siredmar/FilamentRecycle/Mechanic/Caliper/FilamentRight.stl

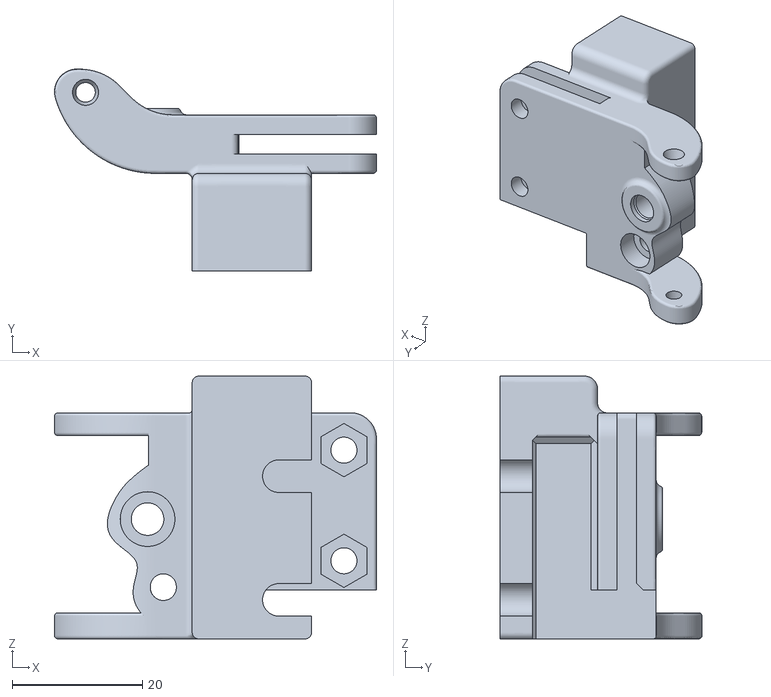
[picture p1: CAD file, 2017-01-15]
Mechanic/Caliper/FilamentRight.stl
49.5 x 31.0 x 40.4
