siredmar/FilamentRecycle/Mechanic/Caliper/FilamentLeft.stl

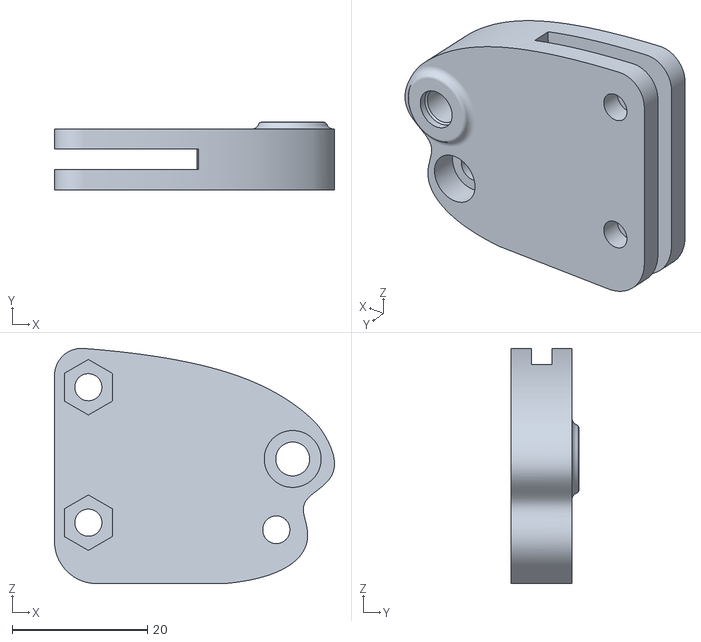
[picture p2: CAD file, 2017-01-15]
Mechanic/Caliper/FilamentLeft.stl
41.3 x 10.0 x 34.7
