siredmar/FilamentRecycle/HW/FilamentRecycle/FilamentRecyclePeriphery.brd

## EAGLE design HW/FilamentRecycle/FilamentRecyclePeriphery.brd (2017-06-21)

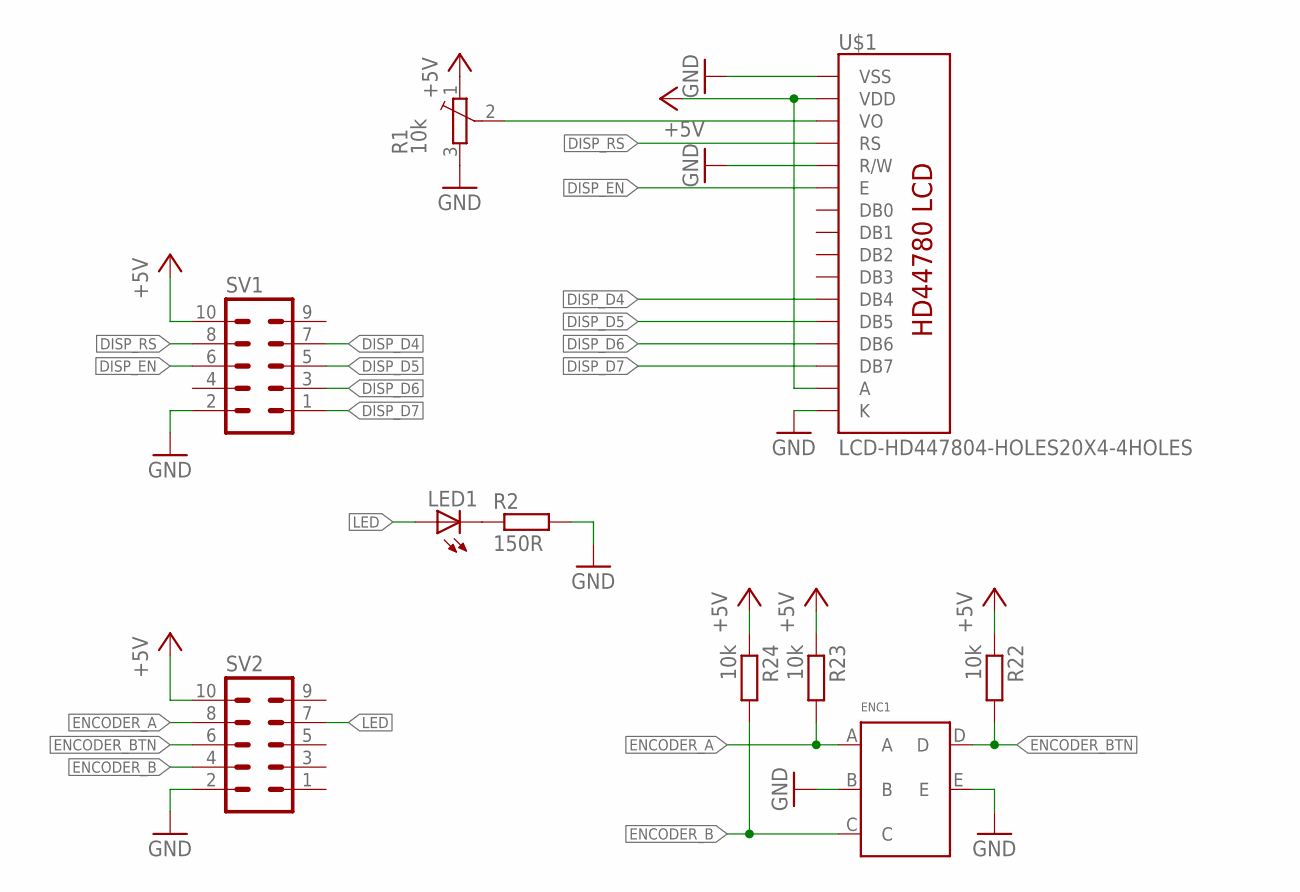
[picture p3: schematic FilamentRecyclePeriphery.sch]

Parts:
ENC1: ENCODER
LED1: LED3MM
R1: 10k; 35WR5KLFTR
R2: 150R; R0603
R22, R23, R24: 10k; R0603
SV1, SV2: ML10
U$1: LCD-HD447804-HOLES20X4-4HOLES; LCD-20X4-4HOLES

Connections:
+5V: R1.1 (E), R22.1, R23.1, R24.1, SV1.10, SV2.10, U$1.P$2 (VDD), U$1.P$15 (A)
DISP_D4: SV1.7, U$1.P$11 (DB4)
DISP_D5: SV1.5, U$1.P$12 (DB5)
DISP_D6: SV1.3, U$1.P$13 (DB6)
DISP_D7: SV1.1, U$1.P$14 (DB7)
DISP_EN: SV1.6, U$1.P$6 (E)
DISP_RS: SV1.8, U$1.P$4 (RS)
ENCODER_A: ENC1.A, R23.2, SV2.8
ENCODER_B: ENC1.C, R24.2, SV2.4
ENCODER_BTN: ENC1.D, R22.2, SV2.6
GND: ENC1.B, ENC1.E, R1.3 (A), R2.2, SV1.2, SV2.2, U$1.P$1 (VSS), U$1.P$5 (R/W), U$1.P$16 (K)
LED: LED1.A, SV2.7
unnamed: LED1.K (C), R2.1
unnamed: R1.2 (S), U$1.P$3 (VO)

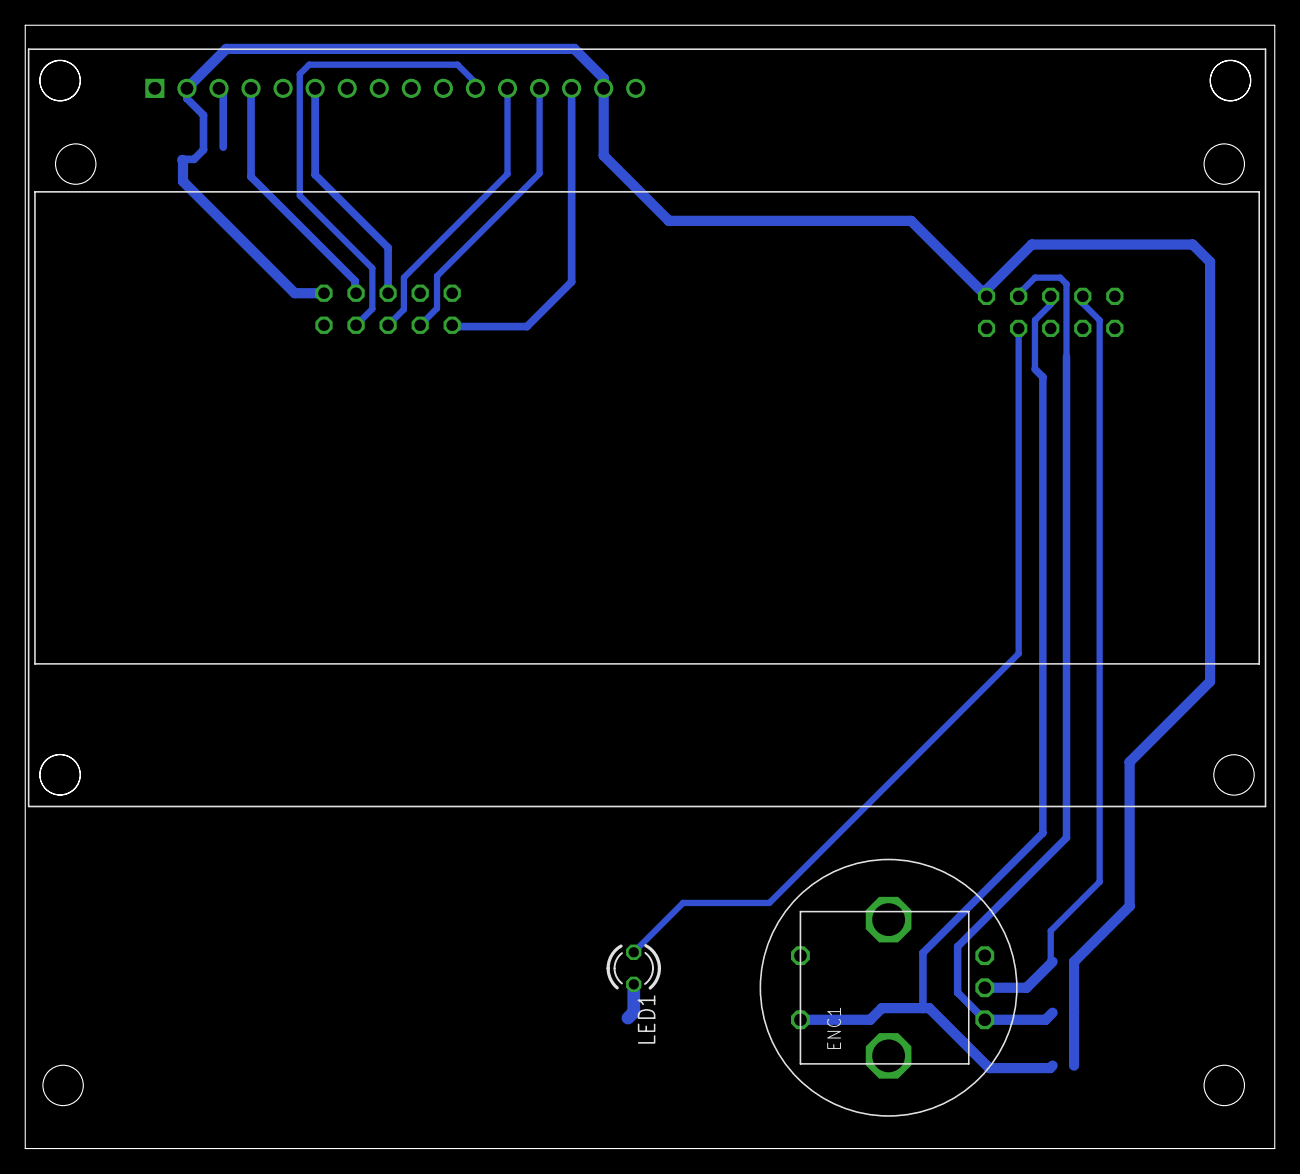
[picture p4: board FilamentRecyclePeriphery.brd from above]

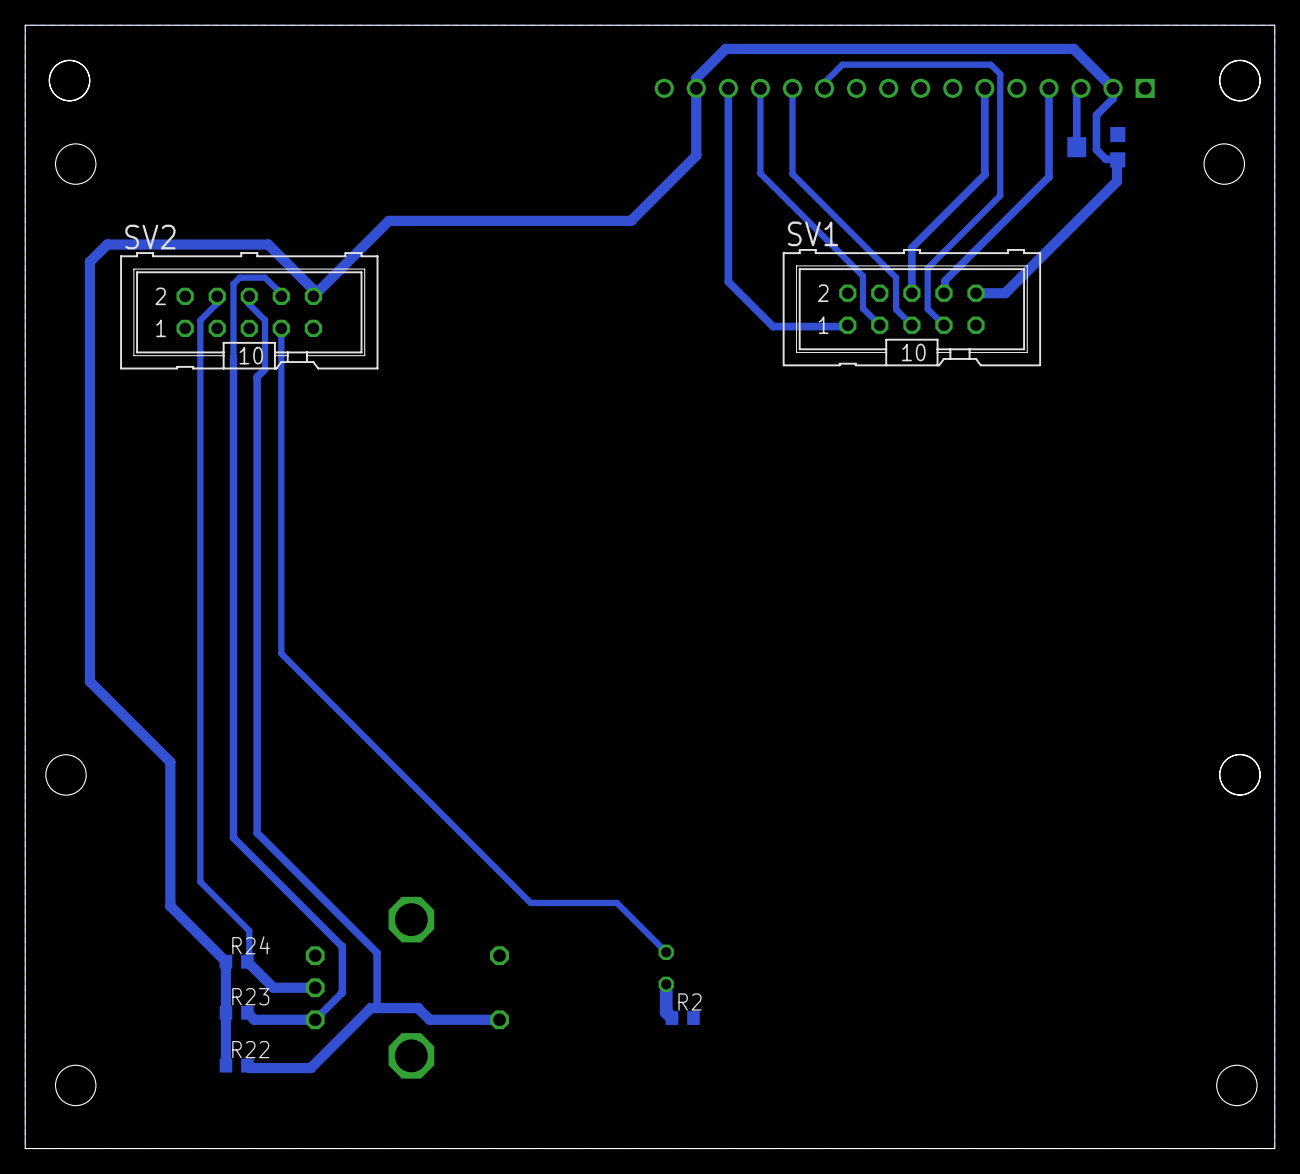
[picture p5: board FilamentRecyclePeriphery.brd from below]

Board: 2 copper layers, 99.0 x 89.0 mm, 10 parts (7 on the bottom side), 14 nets.
