siredmar/FilamentRecycle/HW/FilamentRecycle/FilamentRecycle.brd

## EAGLE design HW/FilamentRecycle/FilamentRecycle.brd (2017-06-21)

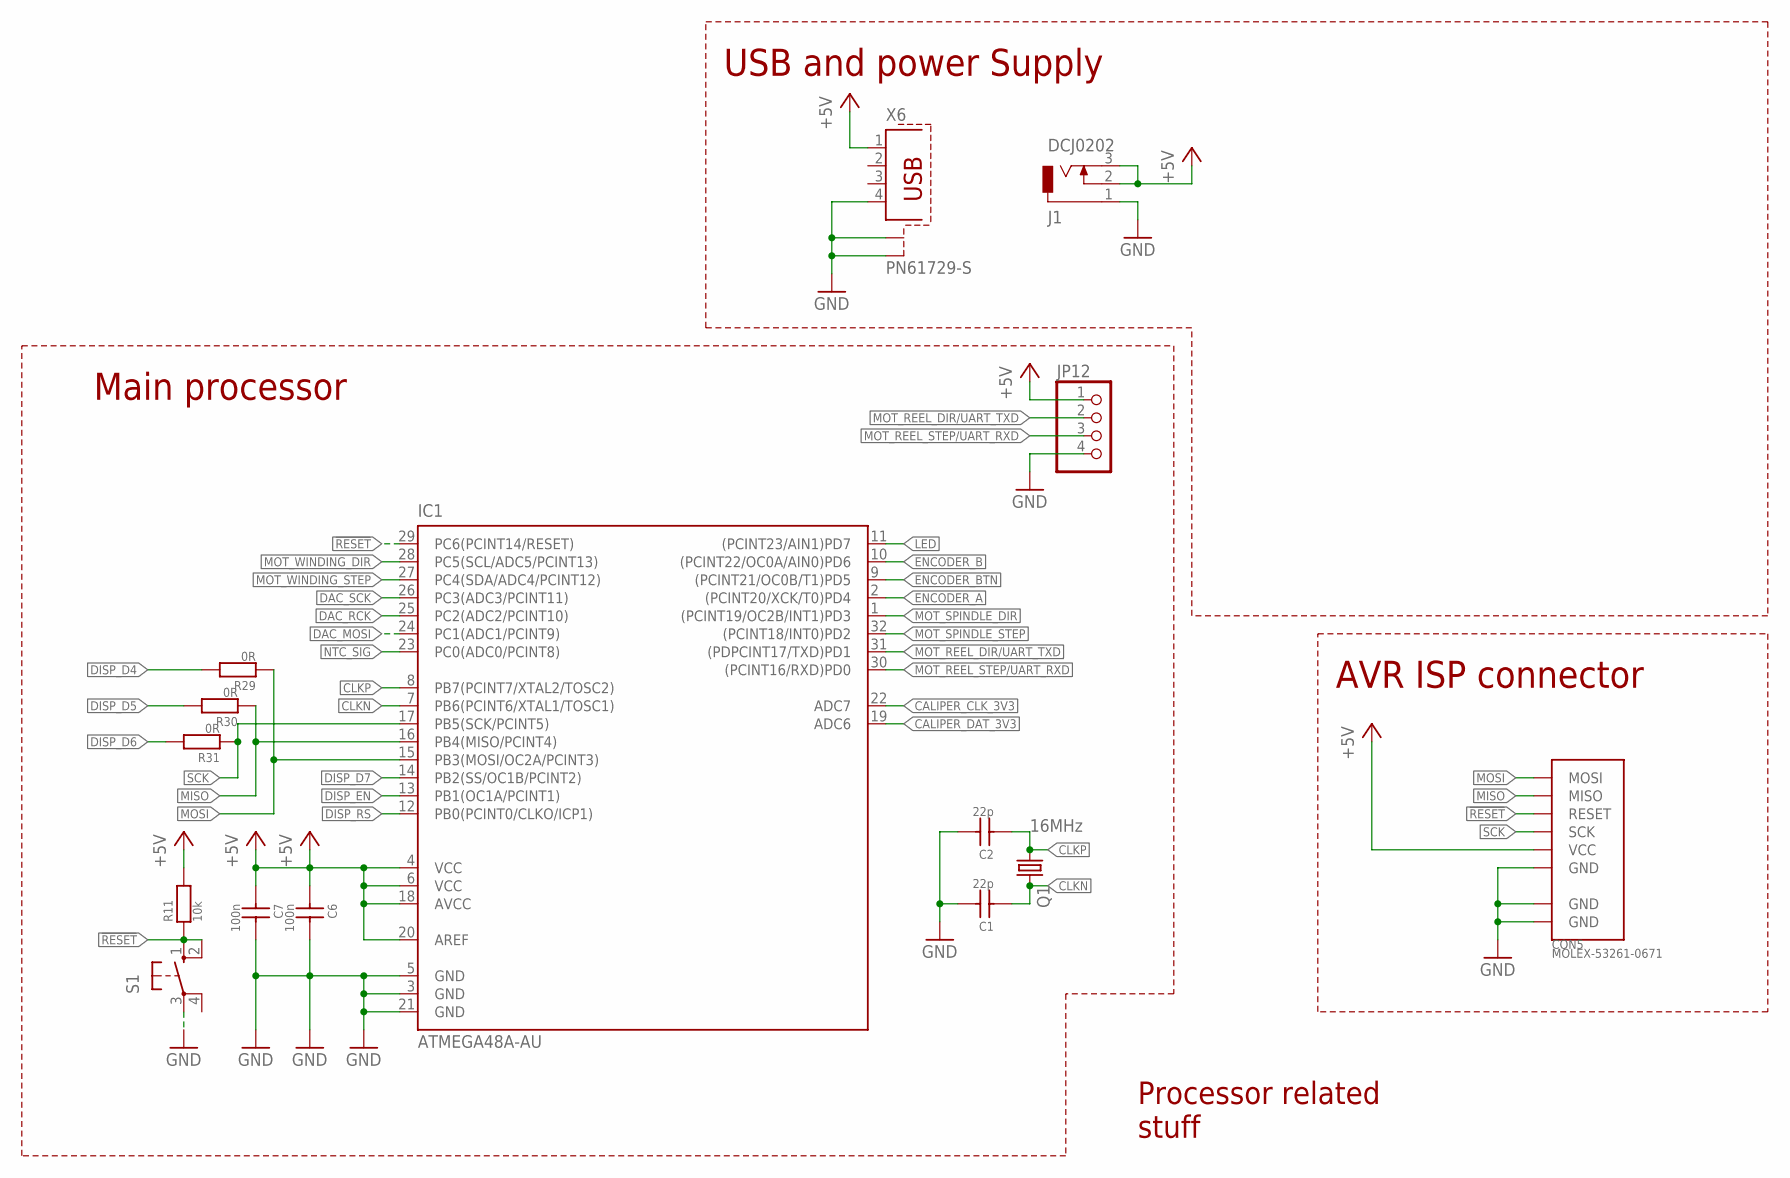
[picture p6: schematic FilamentRecycle.sch, sheet 1]

Parts:
C1, C2: 22p; C0603
C6, C7: 100n; C0603
CON5: MOLEX-53261-0671
IC1: ATMEGA48A-AU; TQFP32
J1: DCJ0202
JP12: PINHD-1X4; 1X04
Q1: 16MHz; HC49UP
R11: 10k; R0603
R29, R30, R31: 0R; R0603
S1: 10-XX; B3F-10XX
X6: PN61729-S

Connections:
!RESET: CON5.3 (RESET), IC1.29 (PC6(PCINT14/RESET)), R11.1, S1.1 (S), S1.2 (S1)
+5V: C6.1, C7.1, CON5.5 (VCC), IC1.4 (VCC), IC1.6 (VCC), IC1.18 (AVCC), IC1.20 (AREF), J1.2, J1.3, JP12.1, R11.2, X6.1; also elsewhere on the board
CALIPER_CLK_3V3: IC1.22 (ADC7); also elsewhere on the board
CALIPER_DAT_3V3: IC1.19 (ADC6); also elsewhere on the board
CLKN: C1.1, IC1.7 (PB6(PCINT6/XTAL1/TOSC1)), Q1.2
CLKP: C2.1, IC1.8 (PB7(PCINT7/XTAL2/TOSC2)), Q1.1
DAC_MOSI: IC1.24 (PC1(ADC1/PCINT9)); also elsewhere on the board
DAC_RCK: IC1.25 (PC2(ADC2/PCINT10)); also elsewhere on the board
DAC_SCK: IC1.26 (PC3(ADC3/PCINT11)); also elsewhere on the board
DISP_D4: R29.2; also elsewhere on the board
DISP_D5: R30.2; also elsewhere on the board
DISP_D6: R31.2; also elsewhere on the board
DISP_D7: IC1.14 (PB2(SS/OC1B/PCINT2)); also elsewhere on the board
DISP_EN: IC1.13 (PB1(OC1A/PCINT1)); also elsewhere on the board
DISP_RS: IC1.12 (PB0(PCINT0/CLKO/ICP1)); also elsewhere on the board
ENCODER_A: IC1.2 ((PCINT20/XCK/T0)PD4); also elsewhere on the board
ENCODER_B: IC1.10 ((PCINT22/OC0A/AIN0)PD6); also elsewhere on the board
ENCODER_BTN: IC1.9 ((PCINT21/OC0B/T1)PD5); also elsewhere on the board
GND: C1.2, C2.2, C6.2, C7.2, CON5.6 (GND), CON5.GND@1 (GND), CON5.GND@2 (GND), IC1.3 (GND), IC1.5 (GND), IC1.21 (GND), J1.1, JP12.4, S1.3, X6.4, X6.S1, X6.S2; also elsewhere on the board
LED: IC1.11 ((PCINT23/AIN1)PD7); also elsewhere on the board
MISO: CON5.2 (MISO), IC1.16 (PB4(MISO/PCINT4)), R30.1
MOSI: CON5.1 (MOSI), IC1.15 (PB3(MOSI/OC2A/PCINT3)), R29.1
MOT_REEL_DIR/UART_TXD: IC1.31 ((PDPCINT17/TXD)PD1), JP12.2; also elsewhere on the board
MOT_REEL_STEP/UART_RXD: IC1.30 ((PCINT16/RXD)PD0), JP12.3; also elsewhere on the board
MOT_SPINDLE_DIR: IC1.1 ((PCINT19/OC2B/INT1)PD3); also elsewhere on the board
MOT_SPINDLE_STEP: IC1.32 ((PCINT18/INT0)PD2); also elsewhere on the board
MOT_WINDING_DIR: IC1.28 (PC5(SCL/ADC5/PCINT13)); also elsewhere on the board
MOT_WINDING_STEP: IC1.27 (PC4(SDA/ADC4/PCINT12)); also elsewhere on the board
NTC_SIG: IC1.23 (PC0(ADC0/PCINT8)); also elsewhere on the board
SCK: CON5.4 (SCK), IC1.17 (PB5(SCK/PCINT5)), R31.1

Notes on the sheet:
Main processor
AVR ISP connector
USB and power Supply
Processor related stuff

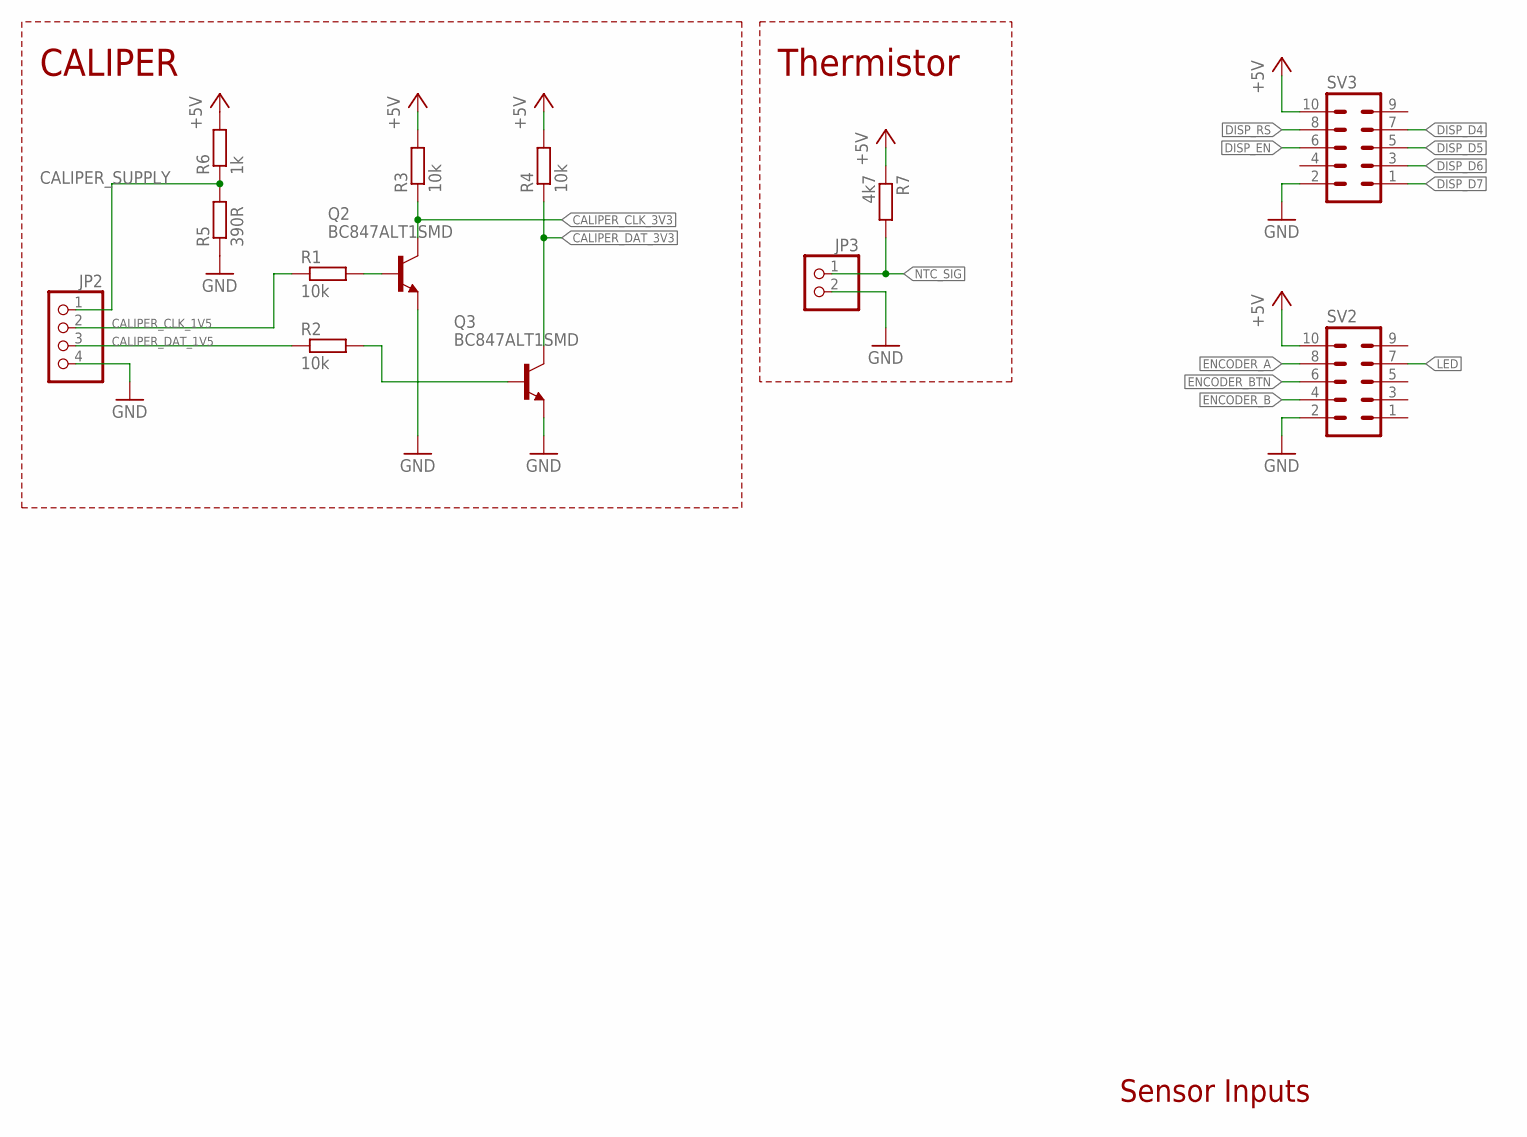
[picture p7: schematic FilamentRecycle.sch, sheet 2]

Parts:
JP2: PINHD-1X4; 1X04
JP3: PINHD-1X2; 1X02
Q2, Q3: BC847ALT1SMD; SOT23
R1, R2, R3, R4: 10k; R0603
R5: 390R; R0603
R6: 1k; R0603
R7: 4k7; R0603
SV2, SV3: ML10

Connections:
+5V: R3.2, R4.2, R6.2, R7.1, SV2.10, SV3.10; also elsewhere on the board
CALIPER_CLK_1V5: JP2.2, R1.1
CALIPER_CLK_3V3: Q2.3 (C), R3.1; also elsewhere on the board
CALIPER_DAT_1V5: JP2.3, R2.1
CALIPER_DAT_3V3: Q3.3 (C), R4.1; also elsewhere on the board
CALIPER_SUPPLY: JP2.1, R5.2, R6.1
DISP_D4: SV3.7; also elsewhere on the board
DISP_D5: SV3.5; also elsewhere on the board
DISP_D6: SV3.3; also elsewhere on the board
DISP_D7: SV3.1; also elsewhere on the board
DISP_EN: SV3.6; also elsewhere on the board
DISP_RS: SV3.8; also elsewhere on the board
ENCODER_A: SV2.8; also elsewhere on the board
ENCODER_B: SV2.4; also elsewhere on the board
ENCODER_BTN: SV2.6; also elsewhere on the board
GND: JP2.4, JP3.2, Q2.2 (E), Q3.2 (E), R5.1, SV2.2, SV3.2; also elsewhere on the board
LED: SV2.7; also elsewhere on the board
unnamed: Q2.1 (B), R1.2
unnamed: Q3.1 (B), R2.2
NTC_SIG: JP3.1, R7.2; also elsewhere on the board

Notes on the sheet:
CALIPER
Thermistor
Sensor Inputs

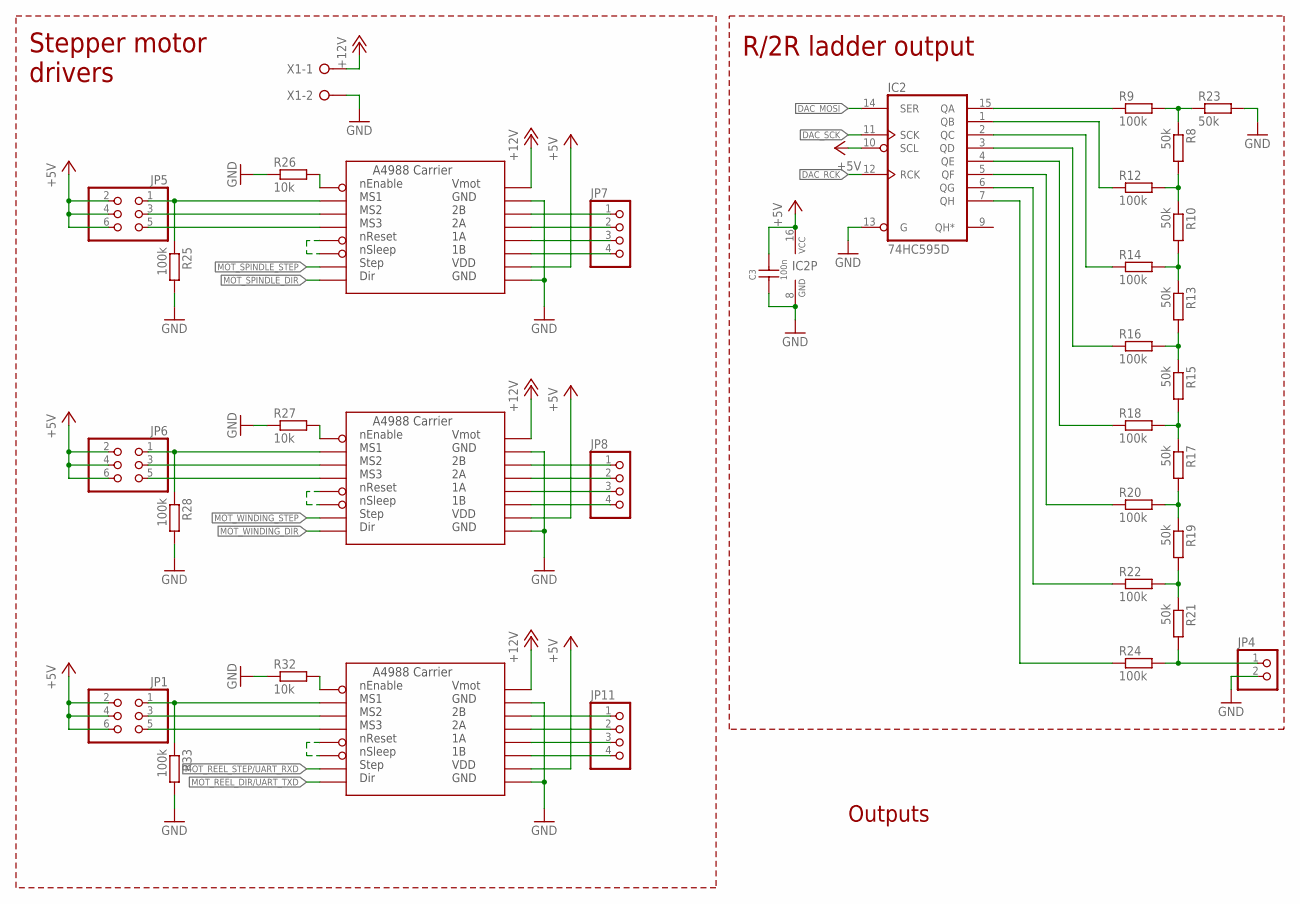
[picture p8: schematic FilamentRecycle.sch, sheet 3]

Parts:
C3: 100n; C0603
IC2: 74HC595D; SO16
JP1, JP5, JP6: PINHD-2X3; 2X03
JP4: PINHD-1X2; 1X02
JP7, JP8, JP11: PINHD-1X4; 1X04
R8, R10, R13, R15, R17, R19, R21, R23: 50k; R0603
R9, R12, R14, R16, R18, R20, R22, R24, R25, R28, R33: 100k; R0603
R26, R27, R32: 10k; R0603
U$7, U$9, U$14: A4988BREAKOUT
X1: W237-02P; W237-132

Connections:
!MOT_SPINDLE_EN: R26.2, U$7.EN
!MOT_WINDING_EN: R27.2, U$14.EN
!MOT_WINDING_EN1: R32.2, U$9.EN
+5V: C3.2, IC2.10 (SCL), IC2.16 (VCC), JP1.2, JP1.4, JP1.6, JP5.2, JP5.4, JP5.6, JP6.2, JP6.4, JP6.6, U$7.VDD, U$9.VDD, U$14.VDD; also elsewhere on the board
+12V: U$7.VMOT, U$9.VMOT, U$14.VMOT, X1.1
DAC_MOSI: IC2.14 (SER); also elsewhere on the board
DAC_RCK: IC2.12 (RCK); also elsewhere on the board
DAC_SCK: IC2.11 (SCK); also elsewhere on the board
GND: C3.1, IC2.8 (GND), IC2.13 (G), JP4.2, R23.2, R25.2, R26.1, R27.1, R28.2, R32.1, R33.2, U$7.GND@0 (GND), U$7.GND@1 (GND), U$9.GND@0 (GND), U$9.GND@1 (GND), U$14.GND@0 (GND), U$14.GND@1 (GND), X1.2; also elsewhere on the board
MOT_REEL_DIR/UART_TXD: U$9.DIR; also elsewhere on the board
MOT_REEL_STEP/UART_RXD: U$9.STEP; also elsewhere on the board
MOT_SPINDLE_DIR: U$7.DIR; also elsewhere on the board
MOT_SPINDLE_STEP: U$7.STEP; also elsewhere on the board
MOT_WINDING_DIR: U$14.DIR; also elsewhere on the board
MOT_WINDING_STEP: U$14.STEP; also elsewhere on the board
unnamed: JP1.5, U$9.MS3
unnamed: JP1.1, R33.1, U$9.MS1
unnamed: JP4.1, R21.2, R24.2
unnamed: R19.2, R21.1, R22.2
unnamed: JP1.3, U$9.MS2
unnamed: R17.2, R19.1, R20.2
unnamed: JP11.1, U$9.2B
unnamed: R15.2, R17.1, R18.2
unnamed: R13.2, R15.1, R16.2
unnamed: R10.2, R13.1, R14.2
unnamed: R8.2, R10.1, R12.2
unnamed: R8.1, R9.2, R23.1
unnamed: IC2.15 (QA), R9.1
unnamed: IC2.1 (QB), R12.1
unnamed: IC2.2 (QC), R14.1
unnamed: IC2.3 (QD), R16.1
unnamed: IC2.4 (QE), R18.1
unnamed: IC2.5 (QF), R20.1
unnamed: IC2.6 (QG), R22.1
unnamed: IC2.7 (QH), R24.1
unnamed: JP5.5, U$7.MS3
unnamed: U$7.RST, U$7.SLP (SLEEP)
unnamed: JP5.1, R25.1, U$7.MS1
unnamed: JP5.3, U$7.MS2
unnamed: JP7.1, U$7.2B
unnamed: JP7.2, U$7.2A
unnamed: JP7.3, U$7.1A
unnamed: JP7.4, U$7.1B
unnamed: JP11.2, U$9.2A
unnamed: JP6.5, U$14.MS3
unnamed: JP6.1, R28.1, U$14.MS1
unnamed: JP6.3, U$14.MS2
unnamed: JP8.1, U$14.2B
unnamed: JP8.2, U$14.2A
unnamed: JP8.3, U$14.1A
unnamed: JP8.4, U$14.1B
unnamed: U$14.RST, U$14.SLP (SLEEP)
unnamed: JP11.3, U$9.1A
unnamed: JP11.4, U$9.1B
unnamed: U$9.RST, U$9.SLP (SLEEP)

Notes on the sheet:
R/2R ladder output
Stepper motor drivers
Outputs

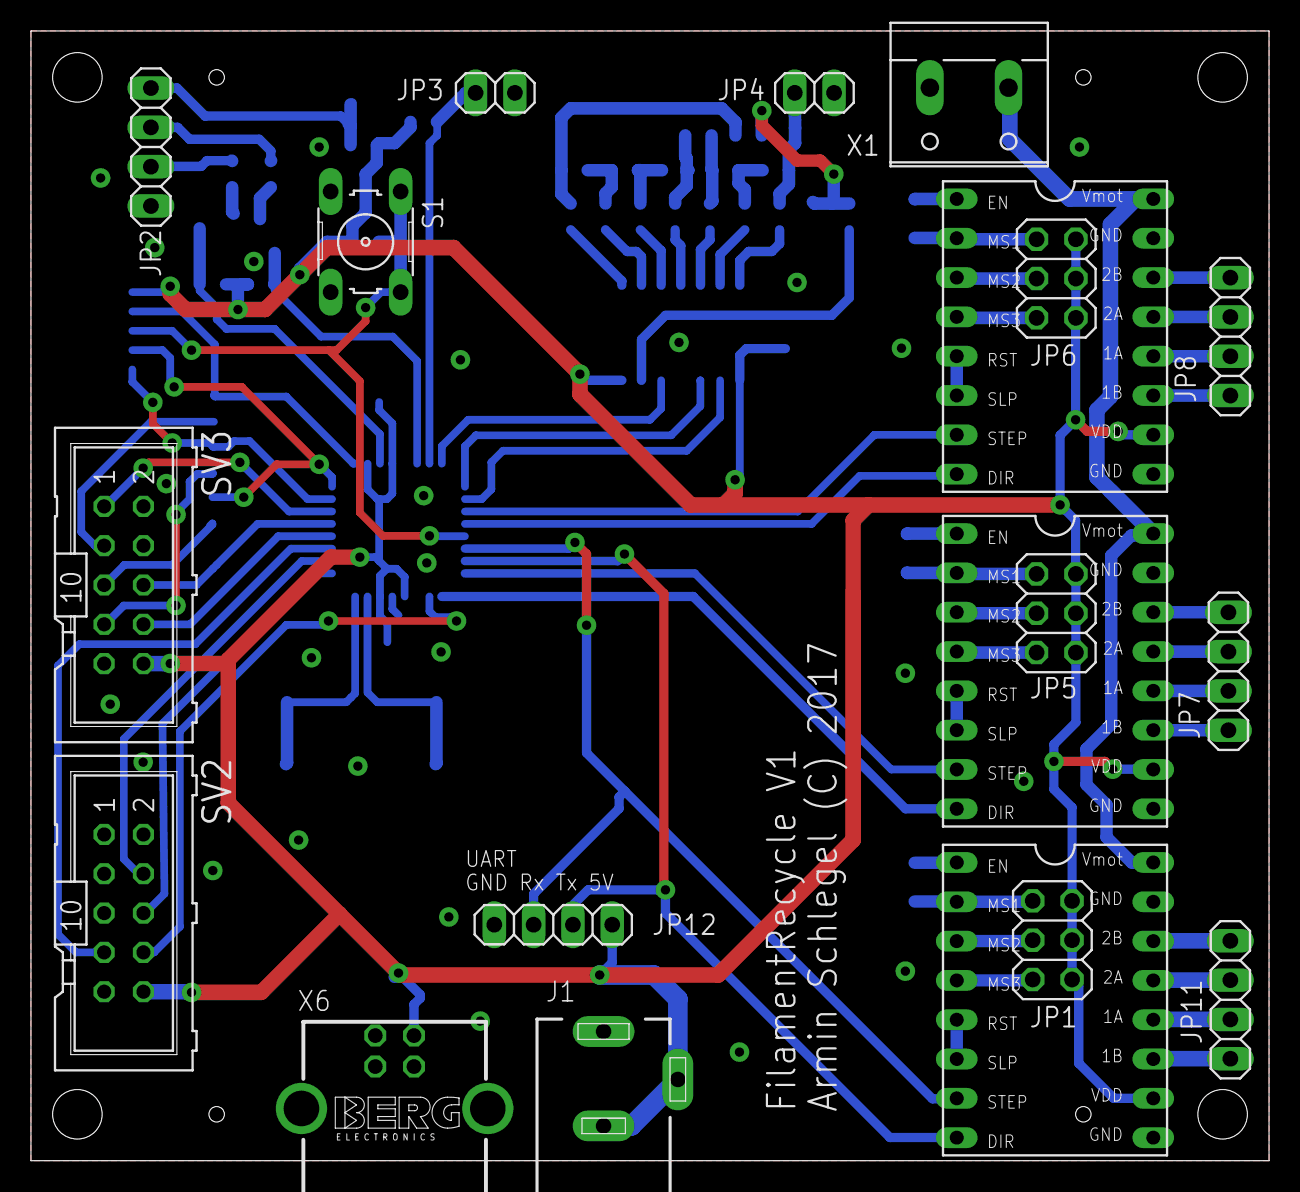
[picture p9: board FilamentRecycle.brd from above]

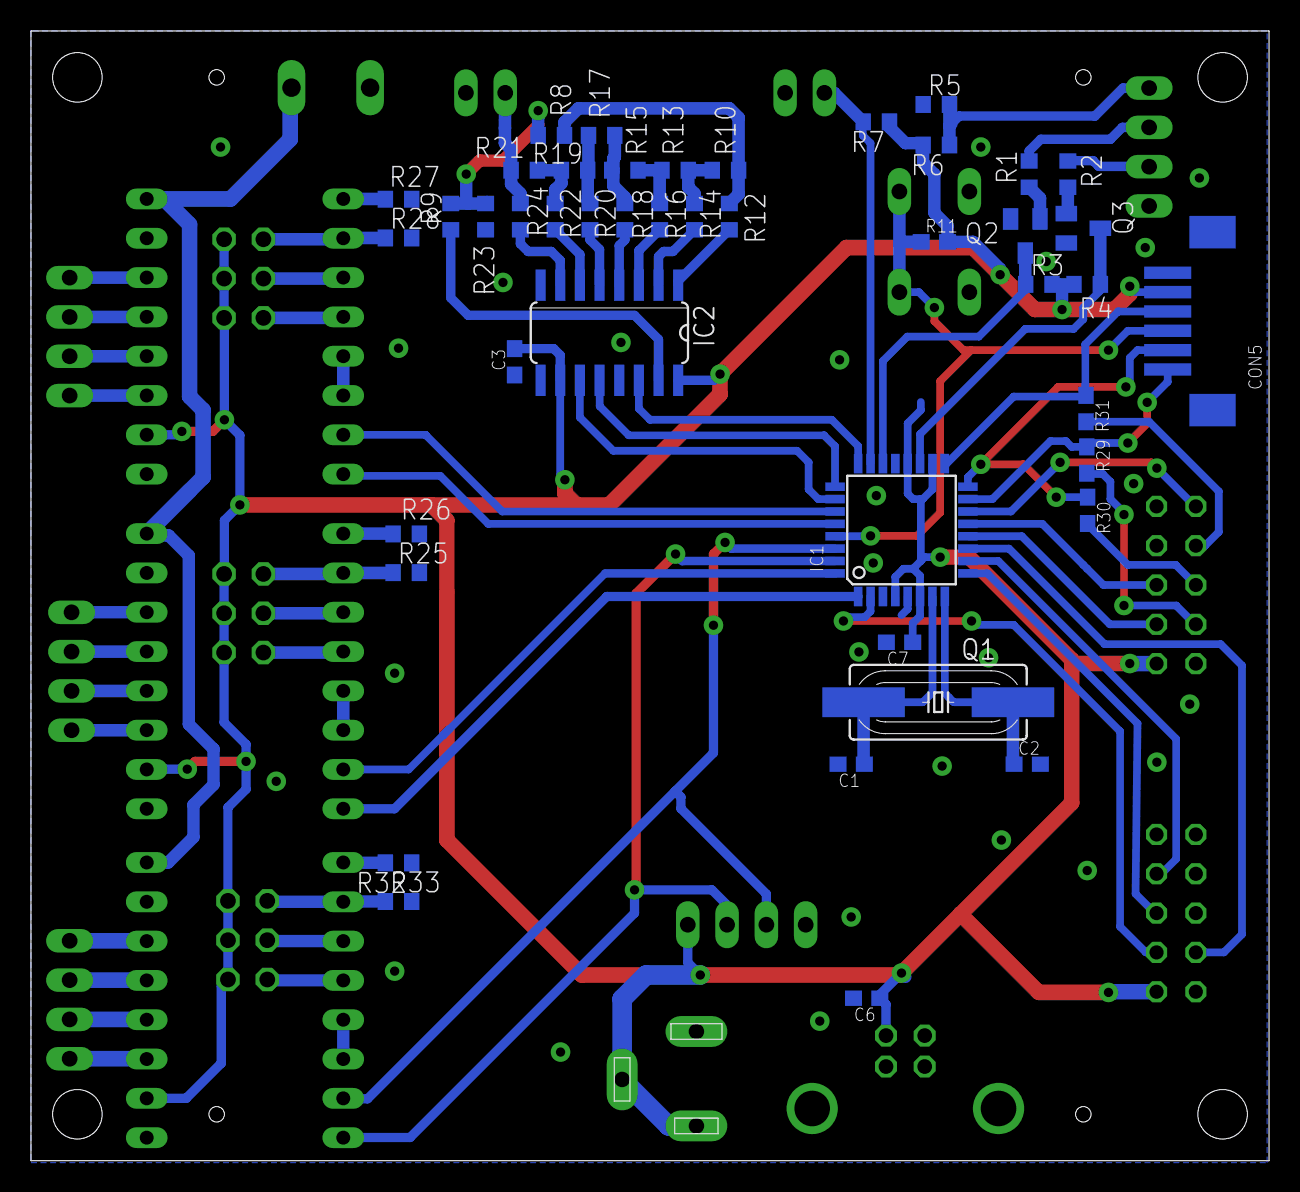
[picture p10: board FilamentRecycle.brd from below]

Board: 2 copper layers, 80.0 x 73.0 mm, 63 parts (44 on the bottom side), 79 nets.
