siredmar/FilamentRecycle/SW/embedded_328/src/Bsw/Pid/Pid.c

#include <inttypes.h>
#include "Pid.h"

uint16 reg_adco_deg(uint16 value)
{
 uint16 degree = 0;
 static const float temp1=23;
  static const float adc1=275;  //ADC-Wert=215 @ 150°C

  static const float temp2=300;
  static const float adc2=172;  //ADC-Wert=152 @ 240°C


  float m=((temp1-temp2)/(adc1-adc2));
  degree = ((uint16) ((m* (float)value) + (-m*adc1) + temp1));
  return degree;
}

/*void main(void)
{
  PID_Einstellung Regler1;
  PID_Init(&Regler1);

  int Ausgang, w,x;

  while(1)
  {
    PID_Cyclic(x,w,&Regler1);
  }
}
*/

/*
void PID_Init()
{
  pid.y=0;
  pid.Ta=100;		 // Abtastzeit in ms
  pid.I=1;		// Integralanteil
  pid.D=0;		// Differenzieller Anteil
  pid.Kp=1;
  o pid.esum=0;		// Summe der Regelabweichungen
  pid.e=0;                   // Regelabweichung
  pid.ealt=0;                  // Regelabweichung zum ZP z-1
}


void PID_Cyclic (int x, int w, PID_Einstellung* PID)
{
  PID->e = w - x;                                   // aktuelle Regelabweichung bestimmen
  if ((PID->y < 1023)&&(PID->y > 0))
   {                                           // (Anti-Windup)
        PID->esum = PID->esum + PID->e;                               // Summe der Regelabweichung aktualisieren
    }
  PID->y = (PID->Kp*PID->e)+(PID->I*PID->Ta*PID->esum)+(PID->D*((PID->e-PID->ealt))/PID->Ta);    // Reglergleichung
  PID->ealt = PID->e;
  if (PID->y > 1023)
   {
      PID->y = 1023;
    }
  if (PID->y < 1)
    {
      PID->y = 0;
    }

}
*/
