siredmar/FilamentRecycle/SW/embedded_328/src/Hal/Lcd/Lcd.h

// Ansteuerung eines HD44780 kompatiblen LCD im 4-Bit-Interfacemodus
// based on http://www.mikrocontroller.net/articles/AVR-GCC-Tutorial/LCD-Ansteuerung
//

#ifndef LCD_ROUTINES_H
#define LCD_ROUTINES_H
#include "Std_Types.h"
#include "Gpio.h"

#define LCD_D6        (GPIO_CHANNEL_PB5)
#define LCD_D5        (GPIO_CHANNEL_PB4)
#define LCD_D4        (GPIO_CHANNEL_PB3)
#define LCD_D7        (GPIO_CHANNEL_PB2)
#define LCD_EN        (GPIO_CHANNEL_PB1)
#define LCD_RS        (GPIO_CHANNEL_PB0)

#define LCD_BOOTUP_MS           15
#define LCD_ENABLE_US           50
#define LCD_WRITEDATA_US        46
#define LCD_COMMAND_US          1

#define LCD_SOFT_RESET_MS1      5
#define LCD_SOFT_RESET_MS2      1
#define LCD_SOFT_RESET_MS3      1
#define LCD_SET_4BITMODE_MS     5

#define LCD_CLEAR_DISPLAY_MS    2
#define LCD_CURSOR_HOME_MS      2

#define LCD_DDADR_LINE1         0x00
#define LCD_DDADR_LINE2         0x40
#define LCD_DDADR_LINE3         0x14
#define LCD_DDADR_LINE4         0x54

typedef enum
{
    LCD_COMMAND = 0,
    LCD_DATA
} Lcd_CommandDataType;

void Lcd_Init(void);
void Lcd_Clear(void);
void Lcd_Home(void);
void Lcd_SetCursor(uint8 spalte, uint8 zeile);
void Lcd_Data(uint8 data);
void Lcd_String(const char *data);
void Lcd_GenerateChar(uint8 startadresse, const uint8 *data);
void Lcd_Command(uint8 data);

// Clear Display -------------- 0b00000001
#define LCD_CLEAR_DISPLAY       0x01

// Cursor Home ---------------- 0b0000001x
#define LCD_CURSOR_HOME         0x02

// Set Entry Mode ------------- 0b000001xx
#define LCD_SET_ENTRY           0x04

#define LCD_ENTRY_DECREASE      0x00
#define LCD_ENTRY_INCREASE      0x02
#define LCD_ENTRY_NOSHIFT       0x00
#define LCD_ENTRY_SHIFT         0x01

// Set Display ---------------- 0b00001xxx
#define LCD_SET_DISPLAY         0x08

#define LCD_DISPLAY_OFF         0x00
#define LCD_DISPLAY_ON          0x04
#define LCD_CURSOR_OFF          0x00
#define LCD_CURSOR_ON           0x02
#define LCD_BLINKING_OFF        0x00
#define LCD_BLINKING_ON         0x01

// Set Shift ------------------ 0b0001xxxx
#define LCD_SET_SHIFT           0x10

#define LCD_CURSOR_MOVE         0x00
#define LCD_DISPLAY_SHIFT       0x08
#define LCD_SHIFT_LEFT          0x00
#define LCD_SHIFT_RIGHT         0x04

// Set Function --------------- 0b001xxxxx
#define LCD_SET_FUNCTION        0x20

#define LCD_FUNCTION_4BIT       0x00
#define LCD_FUNCTION_8BIT       0x10
#define LCD_FUNCTION_1LINE      0x00
#define LCD_FUNCTION_2LINE      0x08
#define LCD_FUNCTION_5X7        0x00
#define LCD_FUNCTION_5X10       0x04

#define LCD_SOFT_RESET          0x03

// Set CG RAM Address --------- 0b01xxxxxx  (Character Generator RAM)
#define LCD_SET_CGADR           0x40

#define LCD_GC_CHAR0            0
#define LCD_GC_CHAR1            1
#define LCD_GC_CHAR2            2
#define LCD_GC_CHAR3            3
#define LCD_GC_CHAR4            4
#define LCD_GC_CHAR5            5
#define LCD_GC_CHAR6            6
#define LCD_GC_CHAR7            7

// Set DD RAM Address --------- 0b1xxxxxxx  (Display Data RAM)
#define LCD_SET_DDADR           0x80

#endif
