siredmar/FilamentRecycle/SW/embedded_328/src/Bsw/Dbg/Dbg.h

/*
 * Dbg.h
 *
 *  Created on: Oct 24, 2015
 *      Author: armin
 */

#ifndef SRC_DBG_DBG_H_
#define SRC_DBG_DBG_H_
#include "Uart.h"
#include "Gpio_Cfg.h"

void Dbg_ReadRegister(uint8 UartHwUnit, uint8 str[], uint8 address);

void Dbg_ReadVariableInteger(uint8 str[], sint32 variable);
void Dbg_ReadVariableIntegerUnsigned(uint8 str[], uint32 variable);
void Dbg_ReadVariableFloat(uint8 str[], float32 variable);
#endif /* SRC_DBG_DBG_H_ */
