siredmar/FilamentRecycle/SW/embedded_328/src/Bsw/Gpio/Gpio_Lcfg.c

#include "Gpio_Lcfg.h"

#include "Gpio.h"

const Gpio_ConfigType Gpio_InitialConfiguration_s =
{
        {
                /* PORT B */
                {       /* Display RS */
                        GPIO_TRUE,
                        GPIO_CHANNEL_PB0,
                        GPIO_OUTPUT,
                        GPIO_PIN_INITIAL_HIGH
                },
                {       /* Display EN */
                        GPIO_TRUE,
                        GPIO_CHANNEL_PB1,
                        GPIO_OUTPUT,
                        GPIO_PIN_INITIAL_LOW
                },
                {       /* Display D7 */
                        GPIO_TRUE,
                        GPIO_CHANNEL_PB2,
                        GPIO_OUTPUT,
                        GPIO_PIN_INITIAL_LOW
                },
                {       /* Display D4 */
                        GPIO_TRUE,
                        GPIO_CHANNEL_PB3,
                        GPIO_OUTPUT,
                        GPIO_PIN_INITIAL_LOW
                },
                {       /* Display D5 */
                        GPIO_TRUE,
                        GPIO_CHANNEL_PB4,
                        GPIO_OUTPUT,
                        GPIO_PIN_INITIAL_LOW
                },
                {       /* Display D6 */
                        GPIO_TRUE,
                        GPIO_CHANNEL_PB5,
                        GPIO_OUTPUT,
                        GPIO_PIN_INITIAL_LOW
                },
                {
                        GPIO_FALSE,
                        GPIO_CHANNEL_PB6,
                        GPIO_INPUT,
                        GPIO_PIN_INITIAL_HIGH
                },
                {
                        GPIO_FALSE,
                        GPIO_CHANNEL_PB7,
                        GPIO_INPUT,
                        GPIO_PIN_INITIAL_HIGH
                },

                /* PORT C */
                {       /* NTC Thermistor AD-Input */
                        GPIO_FALSE,
                        GPIO_CHANNEL_PC0,
                        GPIO_INPUT,
                        GPIO_PIN_INITIAL_HIGH
                },
                {       /* R2RDAC - HC595 MOSI */
                        GPIO_TRUE,
                        GPIO_CHANNEL_PC1,
                        GPIO_OUTPUT,
                        GPIO_PIN_INITIAL_HIGH
                },
                {       /* R2RDAC - HC595 RCK */
                        GPIO_TRUE,
                        GPIO_CHANNEL_PC2,
                        GPIO_OUTPUT,
                        GPIO_PIN_INITIAL_HIGH
                },
                {       /* R2RDAC - HC595 SCK */
                        GPIO_TRUE,
                        GPIO_CHANNEL_PC3,
                        GPIO_OUTPUT,
                        GPIO_PIN_INITIAL_HIGH
                },
                {
                        GPIO_FALSE,
                        GPIO_CHANNEL_PC4,
                        GPIO_OUTPUT,
                        GPIO_PIN_INITIAL_HIGH
                },
                {
                        GPIO_FALSE,
                        GPIO_CHANNEL_PC5,
                        GPIO_INPUT,
                        GPIO_PIN_INITIAL_HIGH
                },
                {
                        GPIO_FALSE,
                        GPIO_CHANNEL_PC6,
                        GPIO_INPUT,
                        GPIO_PIN_INITIAL_HIGH
                },

                /* PORT D */
                {
                        GPIO_FALSE,
                        GPIO_CHANNEL_PD0,
                        GPIO_INPUT,
                        GPIO_PIN_INITIAL_HIGH
                },
                {
                        GPIO_FALSE,
                        GPIO_CHANNEL_PD1,
                        GPIO_INPUT,
                        GPIO_PIN_INITIAL_HIGH
                },
                {
                        GPIO_FALSE,
                        GPIO_CHANNEL_PD2,
                        GPIO_OUTPUT,
                        GPIO_PIN_INITIAL_HIGH
                },
                {
                        GPIO_FALSE,
                        GPIO_CHANNEL_PD3,
                        GPIO_OUTPUT,
                        GPIO_PIN_INITIAL_HIGH
                },
                {       /* Rotary Encoder Phase A */
                        GPIO_TRUE,
                        GPIO_CHANNEL_PD4,
                        GPIO_INPUT,
                        GPIO_PIN_INITIAL_HIGH
                },
                {       /* Rotary Encoder Button */
                        GPIO_TRUE,
                        GPIO_CHANNEL_PD5,
                        GPIO_INPUT,
                        GPIO_PIN_INITIAL_HIGH
                },
                {       /* Rotary Encoder Phase B */
                        GPIO_TRUE,
                        GPIO_CHANNEL_PD6,
                        GPIO_INPUT,
                        GPIO_PIN_INITIAL_HIGH
                },
                {       /* LED */
                        GPIO_TRUE,
                        GPIO_CHANNEL_PD7,
                        GPIO_OUTPUT,
                        GPIO_PIN_INITIAL_LOW
                }
        }
};





const void *Gpio_GetLcfgData(void)
{
    return ((const void *) &Gpio_InitialConfiguration_s);
}
