siredmar/FilamentRecycle/(commit log)

2017-01-15 Initial commit - added caliper mechanic stl files
    [FilamentLeft.stl, FilamentRight.stl]
2017-01-15 Added reference source for reading the caliper with arduino nano
2017-01-15 Added Hw - still in work
    [FilamentRecycle.brd, FilamentRecycle.sch]
2017-01-17 Reading the caliper via uart working
    [FilamentRecycle.brd, FilamentRecycle.sch]
2017-01-17 first version of NTC handling
    [FilamentRecycle.brd, FilamentRecycle.sch]
2017-01-20 Temperatur reading working with NTC3950 thermistor
    [FilamentRecycle.brd, FilamentRecycle.sch]
2017-01-21 Schematic and board work
    [FilamentRecycle.brd, FilamentRecycle.sch]
2017-01-22 R2R ladder output working via HC595 shift register
    [FilamentRecycle.brd, FilamentRecycle.sch]
2017-01-23 Eagle brd RC1
    [FilamentRecycle.brd, FilamentRecycle.sch]
2017-06-19 First tests of target hardware. DAC, Caliper and thermistor working
    [FilamentRecycle.brd, FilamentRecycle.sch]
2017-06-21 Added LCD library, Fixed hw bug (series resistors for LCD removed)
    [FilamentRecycle.brd, FilamentRecycle.sch]
2017-06-21 Added rotary encoder and application menu
2017-06-21 Added Periphery board
    [FilamentRecycle.GBL, FilamentRecycle.GBO, FilamentRecycle.GBP, FilamentRecycle.GBS, FilamentRecycle.GTL, FilamentRecycle.GTO, FilamentRecycle.GTP, FilamentRecycle.GTS]
2017-06-21 Added LED Handling
