siredmar/FilamentRecycle/(notices)

Notices in the files:
HW/FilamentRecycle/FilamentRecycle.brd:
Armin Schlegel (C) 2017
